jaxx0rr/TrackSwitcher/Images/002.jpg

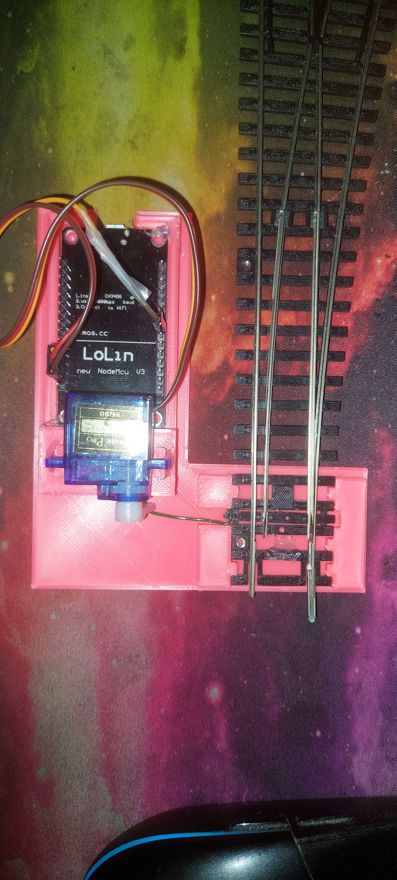
Images/002.jpg
