jaxx0rr/TrackSwitcher/Images/003.jpg

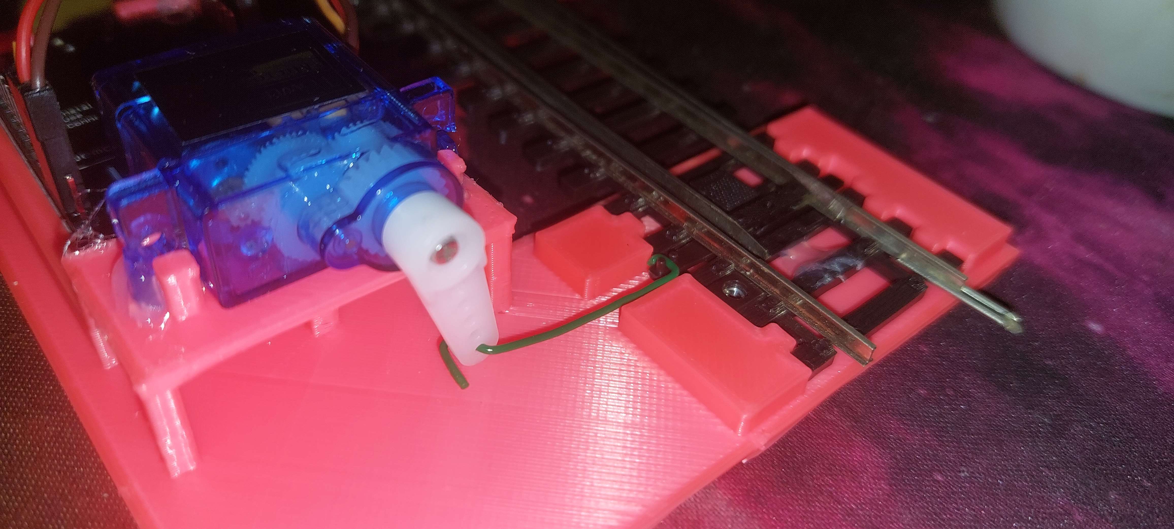
Images/003.jpg
